yuhsinnet/rfid-mobile/RFID-mobileV_1_0/todo.txt

1.ST-LINK 腳位與LoRa 通信腳位過近，不方便使用。
2.RFID 通信腳位使用錯誤(TX RX 交換)。
3.電源3.3V 應由電池端供電，不能由5V 供電。
