yuhsinnet/rfid-mobile/BMW 50010_Case-PCB_dege.dxf

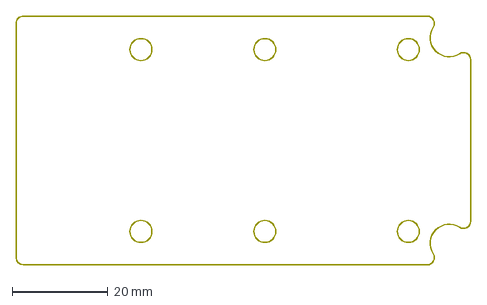
[picture p1: CAD file, 2022-05-01]
BMW 50010_Case-PCB_dege.dxf
95.0 x 52.0 mm
