yuhsinnet/rfid-mobile/BMW 50010_Case.dxf

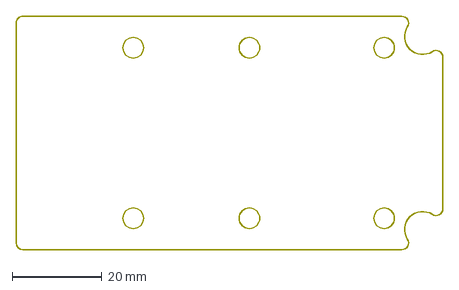
[picture p2: CAD file, 2022-05-01]
BMW 50010_Case.dxf
95.0 x 52.0 mm
