yuhsinnet/rfid-mobile/BMC 70020-Case-PCB_Edge.dxf

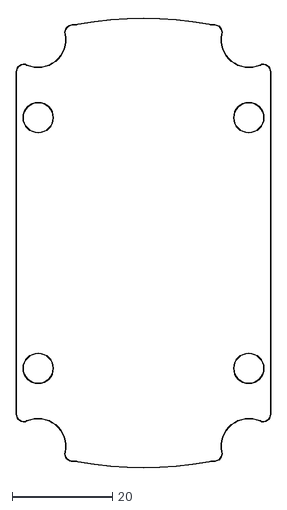
[picture p3: CAD file, 2022-04-29]
BMC 70020-Case-PCB_Edge.dxf
50.7 x 90.3
