yuhsinnet/rfid-mobile/CaseCAD.dxf

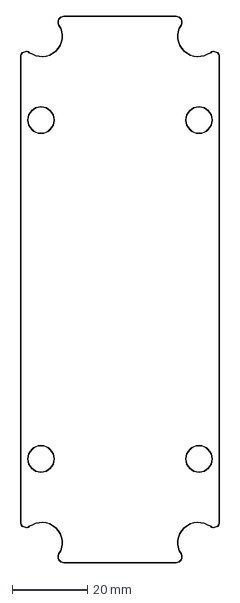
[picture p4: CAD file, 2022-04-24]
CaseCAD.dxf
52.9 x 145.1 mm
