yuhsinnet/rfid-mobile/(list of files, cad)

Other CAD files:
BMC 70020-Case-PCB_Edge_V2.dwg
BMC 70020-Case-raw.dwg
BMC 70022-PDF-CAD.dwg
BMC 70020-Case-PCB_Edge.dwg
BMW 50010_Case-PCB_dege.dwg
CaseCAD.dwg
