yuhsinnet/rfid-mobile/RFID-mobileV_1_0/RFID-mobileV_1_0.kicad_pcb

## KiCad design RFID-mobileV_1_0/RFID-mobileV_1_0.kicad_pcb (2022-06-02)

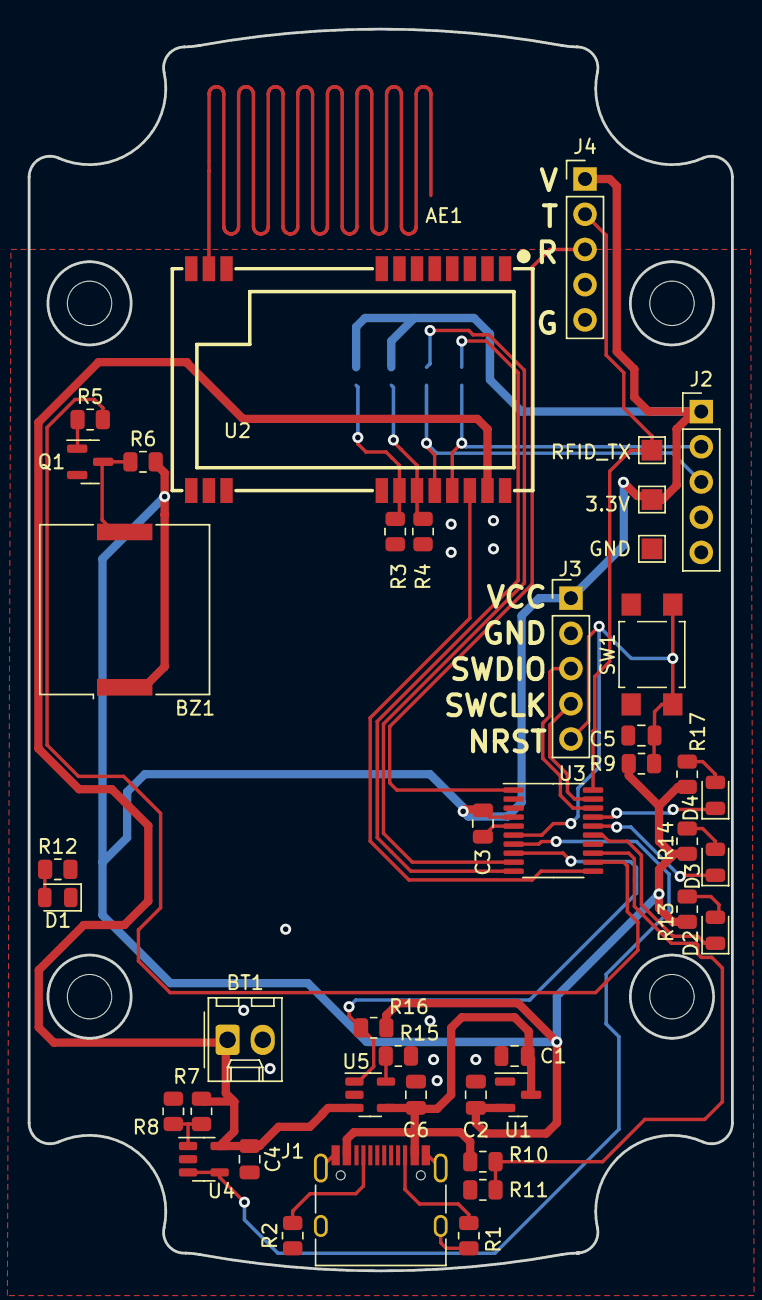
[picture p5: board RFID-mobileV_1_0.kicad_pcb from above]

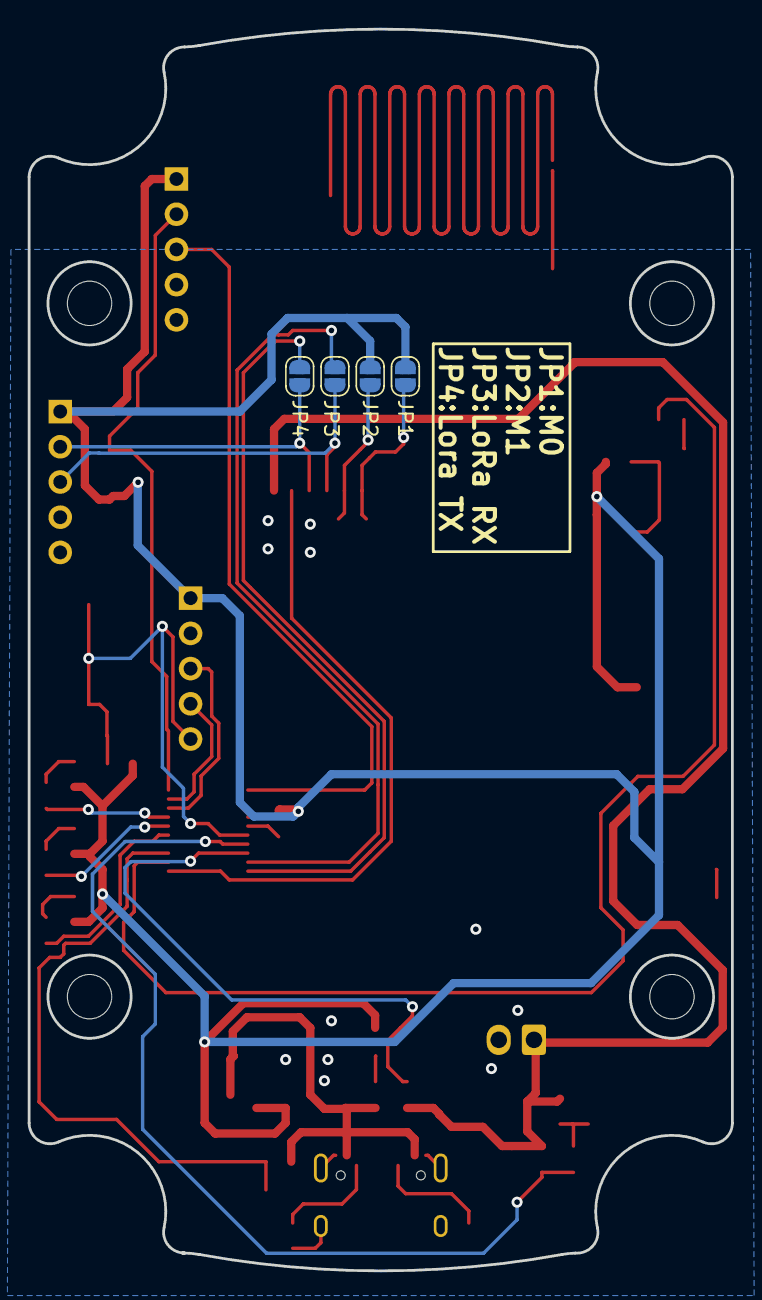
[picture p6: board RFID-mobileV_1_0.kicad_pcb from below]

Board: 2 copper layers, 50.7 x 89.5 mm, 52 parts (4 on the bottom side), 34 nets.

Parts:
AE1: Antenna; 433MHz_V
BT1: Battery; Molex_KK-254_AE-6410-02A_1x02_P2.54mm_Vertical
BZ1: Buzzer; Buzzer_Murata_PKLCS1212E
C1, C2, C3, C4, C5, C6: 0.1uF; C_0805_2012Metric
D1: PWR; LED_0805_2012Metric
D2, D3, D4: LED; LED_0805_2012Metric
H1, H2, H3, H4: MountingHole; MountingHole_3.2mm_M3
J1: USB_C_Receptacle_USB2.0; USB_C_Receptacle_HRO_TYPE-C-31-M-12
J2, J4: Conn_01x05_Male; PinHeader_1x05_P2.54mm_Vertical
J3: Conn_01x05_Female; PinHeader_1x05_P2.54mm_Vertical
JP1, JP2, JP3, JP4: SolderJumper_2_Open; SolderJumper-2_P1.3mm_Open_RoundedPad1.0x1.5mm
Q1: MMBT3904; SOT-23
R1, R2: 5K1; R_0805_2012Metric
R3, R4, R6, R13, R14, R17: 1k; R_0805_2012Metric
R5: 22k; R_0805_2012Metric
R7, R8: 2M; R_0805_2012Metric
R9, R16: 10k; R_0805_2012Metric
R10: 47k; R_0805_2012Metric
R11: 91k; R_0805_2012Metric
R12: 330; R_0805_2012Metric
R15: 1.65K; R_0805_2012Metric
SW1: SW_Push; SW_SPST_TL3305A
TP1: RFID_TX; TestPoint_Pad_1.5x1.5mm
TP2: 3.3V; TestPoint_Pad_1.5x1.5mm
TP3: GND; TestPoint_Pad_1.5x1.5mm
U1: XC6206P332MR; SOT-23
U2: E22-400T22S; E220-400TxxS
U3: STM32G030FxP; TSSOP-20_4.4x6.5mm_P0.65mm
U4: LM321; SOT-23-5
U5: TP4054; TSOT-23-5

Connections:
+3V3: BZ1.1 (-), C2.1, C3.1, J2.1, J3.1, J4.1, JP1.2 (B), JP2.2 (B), R6.2, R9.1, R12.2, R13.2, R14.2, R16.1, R17.2, TP2.1, U1.2 (VO), U3.4 (VDD/VDDA)
+5V: C1.1, C6.1, J1.A4 (VBUS), J1.A9 (VBUS), J1.B4 (VBUS), J1.B9 (VBUS), R10.1, U1.3 (VI), U5.4 (VCC)
+BATT: BT1.1 (+), C4.1, R7.1, U2.25 (VCC), U4.5 (V+), U5.3 (BAT)
/ANT: AE1.1 (A), U2.12 (ANT)
/BATT_moint: U3.7 (PA0), U4.3 (-), U4.4
/CC1: J1.A5 (CC1), R2.2
/CC2: J1.B5 (CC2), R1.2
/CHAR_STAT: R16.2, U3.8 (PA1), U5.1 (~CHRG)
/LoRa_AUX: U2.24 (AUX), U3.11 (PA4)
/LoRa_RXD: JP3.2 (B), U3.9 (PA2)
/LoRa_RXD_: J2.3, JP3.1 (A), U2.22 (RXD)
/LoRa_TXD: JP4.2 (B), U3.10 (PA3)
/LoRa_TXD_: J2.2, JP4.1 (A), U2.23 (TXD)
/M0: JP1.1 (A), R3.2, U2.20 (M0)
/M1: JP2.1 (A), R4.2, U2.21 (M1)
/NRST: C5.1, J3.5, R9.2, SW1.2, U3.6 (NRST)
/PA8: D2.1 (K), U3.15 (PB0/PB1/PB2/PA8)
/PA9: D3.1 (K), U3.16 (PA11[PA9])
/PA10: D4.1 (K), U3.17 (PA12[PA10])
/RFID_RXD_: J4.3, U3.1 (PB7/PB8)
/RFID_TXD_: J4.2, TP1.1, U3.20 (PB3/PB4/PB5/PB6)
/SWCLK: J3.4, U3.19 (PA15/PA14-BOOT0)
/SWDIO: J3.3, U3.18 (PA13)
/VBUS_sing: R10.2, R11.1, U3.13 (PA6)
/buz: R5.2, U3.12 (PA5)
GND: BT1.2 (-), C1.2, C2.2, C3.2, C4.2, C5.2, C6.2, D1.1 (K), J1.A1 (GND), J1.A12 (GND), J1.B1 (GND), J1.B12 (GND), J1.S1 (SHIELD), J2.5, J3.2, J4.5, Q1.2 (E), R1.1, R2.1, R3.1, R4.1, R8.2, R11.2, R15.2, SW1.1, TP3.1, U1.1 (GND), U2.2 (GND), U2.8 (GND), U2.11 (GND), U2.13 (GND), U2.14 (GND), U2.15 (GND), U2.16 (GND), U2.19 (GND), U2.26 (GND), U3.5 (VSS/VSSA), U4.2 (V-), U5.2 (GND)
unnamed: BZ1.2 (+), Q1.3 (C), R6.1
unnamed: D1.2 (A), R12.1
unnamed: D2.2 (A), R13.1
unnamed: D3.2 (A), R14.1
unnamed: D4.2 (A), R17.1
unnamed: Q1.1 (B), R5.1
unnamed: R7.2, R8.1, U4.1 (+)
unnamed: R15.1, U5.5 (PROG)
