yuhsinnet/rfid-mobile/RFID-siteV_1_0/RFID-siteV_1_0.kicad_pcb

## KiCad design RFID-siteV_1_0/RFID-siteV_1_0.kicad_pcb (2022-06-02)

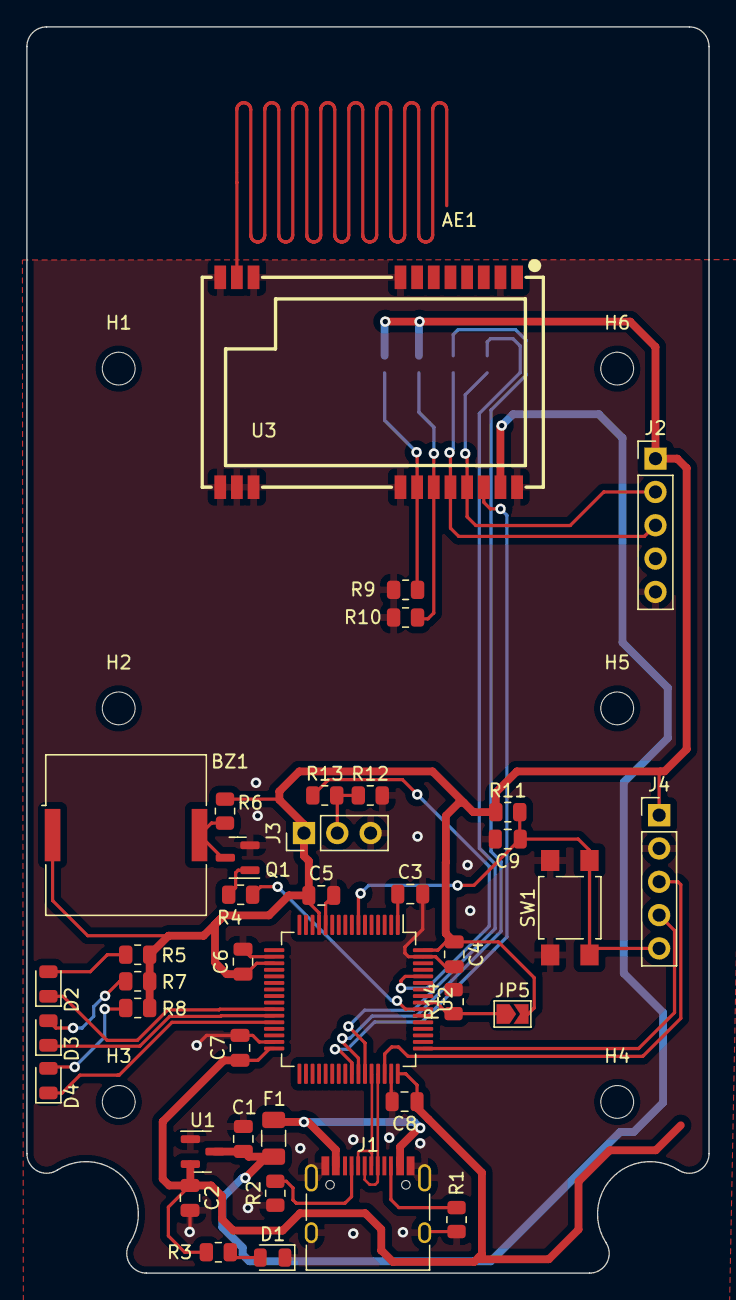
[picture p7: board RFID-siteV_1_0.kicad_pcb from above]

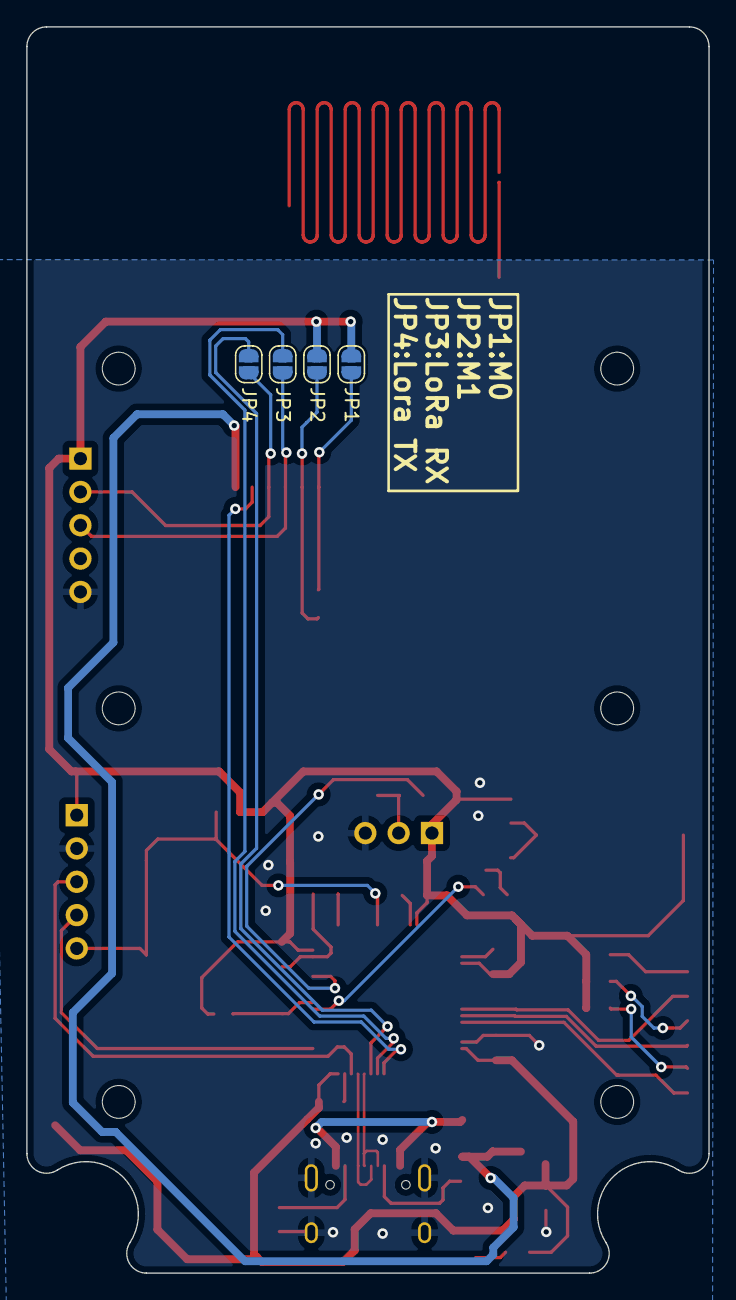
[picture p8: board RFID-siteV_1_0.kicad_pcb from below]

Board: 2 copper layers, 52.0 x 95.0 mm, 50 parts (4 on the bottom side), 33 nets.

Parts:
AE1: Antenna; 433MHz_V
BZ1: Buzzer; Buzzer_Murata_PKLCS1212E
C1, C2, C3, C4, C5, C6, C7, C8, C9: 0.1uF; C_0805_2012Metric
D1: PWR; LED_0805_2012Metric
D2, D3, D4: LED; LED_0805_2012Metric
F1: Fuse 200mA; Fuse_1206_3216Metric
H1, H2, H3, H4, H5, H6: MountingHole; MountingHole_2.5mm
J1: USB_C_Receptacle_USB2.0; USB_C_Receptacle_HRO_TYPE-C-31-M-12
J2: Conn_01x05_Male; PinHeader_1x05_P2.54mm_Vertical
J3: Conn_01x03_Male; PinHeader_1x03_P2.54mm_Vertical
J4: Conn_01x05_Female; PinHeader_1x05_P2.54mm_Vertical
JP1, JP2, JP3, JP4: SolderJumper_2_Open; SolderJumper-2_P1.3mm_Open_RoundedPad1.0x1.5mm
JP5: SolderJumper_2_Open; SolderJumper-2_P1.3mm_Open_TrianglePad1.0x1.5mm
Q1: MMBT3904; SOT-23
R1, R2: 5K1; R_0805_2012Metric
R3: 330; R_0805_2012Metric
R4: 22k; R_0805_2012Metric
R5, R6, R7, R8, R9, R10, R13, R14: 1k; R_0805_2012Metric
R11: 10k; R_0805_2012Metric
R12: 0R; R_0805_2012Metric
SW1: SW_Push; SW_SPST_TL3305A
U1: XC6206P332MR; SOT-23
U2: STM32L053R8Tx; LQFP-64_10x10mm_P0.5mm
U3: E22-400T22S; E220-400TxxS

Connections:
+3V3: BZ1.1 (-), C2.1, C4.1, C5.1, C6.1, C7.1, C8.1, J2.1, J3.1, J4.1, JP1.2 (B), JP2.2 (B), JP5.2 (B), R3.2, R5.2, R6.2, R7.2, R8.2, R11.1, U1.2 (VO), U2.13 (VDDA), U2.19 (VDD), U2.32 (VDD), U2.48 (VDD_USB), U2.64 (VDD)
+5V: C1.1, F1.1, U1.3 (VI), U3.25 (VCC)
/ANT: AE1.1 (A), U3.12 (ANT)
/BOOT0: R13.1, U2.60 (BOOT0)
/CC1: J1.A5 (CC1), R2.2
/CC2: J1.B5 (CC2), R1.2
/L53R8_UART1_RX: JP4.2 (B), U2.43 (PA10)
/L53R8_UART1_TX: JP3.2 (B), U2.42 (PA9)
/LoRa_AUX: U2.41 (PA8), U3.24 (AUX)
/LoRa_RXD_: J2.3, JP3.1 (A), U3.22 (RXD)
/LoRa_TXD_: J2.2, JP4.1 (A), U3.23 (TXD)
/M0: JP1.1 (A), R9.2, U3.20 (M0)
/M1: JP2.1 (A), R10.2, U3.21 (M1)
/NRST: C9.1, J4.5, R11.2, SW1.2, U2.7 (NRST)
/PB0: D2.1 (K), U2.26 (PB0)
/PB1: D3.1 (K), U2.27 (PB1)
/PB2: D4.1 (K), U2.28 (PB2)
/SWCLK: J4.4, U2.49 (PA14)
/SWDIO: J4.3, U2.46 (PA13)
/USB_D+: J1.A6 (D+), J1.B6 (D+), U2.45 (PA12)
/USB_D-: J1.A7 (D-), J1.B7 (D-), U2.44 (PA11)
/buz: R4.2, U2.55 (PB3)
/mod_sel: JP5.1 (A), R14.1, U2.56 (PB4)
GND: C1.2, C2.2, C3.2, C4.2, C5.2, C6.2, C7.2, C8.2, C9.2, D1.1 (K), J1.A1 (GND), J1.A12 (GND), J1.B1 (GND), J1.B12 (GND), J1.S1 (SHIELD), J2.5, J3.3, J4.2, Q1.2 (E), R1.1, R2.1, R9.1, R10.1, R12.2, R14.2, SW1.1, U1.1 (GND), U2.12 (VSSA), U2.18 (VSS), U2.31 (VSS), U2.47 (VSS), U2.63 (VSS), U3.2 (GND), U3.8 (GND), U3.11 (GND), U3.13 (GND), U3.14 (GND), U3.15 (GND), U3.16 (GND), U3.19 (GND), U3.26 (GND)
unnamed: BZ1.2 (+), Q1.3 (C), R6.1
unnamed: C3.1, U2.1 (VLCD)
unnamed: D1.2 (A), R3.1
unnamed: D2.2 (A), R5.1
unnamed: D3.2 (A), R7.1
unnamed: D4.2 (A), R8.1
unnamed: F1.2, J1.A4 (VBUS), J1.A9 (VBUS), J1.B4 (VBUS), J1.B9 (VBUS)
unnamed: J3.2, R12.1, R13.2
unnamed: Q1.1 (B), R4.1
