yuhsinnet/rfid-mobile/RFID-siteV_1_0/todo.txt

1.ST-LINK 腳位上下顛倒，接腳不便使用。
2.缺少模式(加符號&不加符號)選擇接點。
