yuhsinnet/rfid-mobile/(commit log)

2022-04-20 add type-c
    [RFID-mobileV_1_0.kicad_pcb, RFID-mobileV_1_0.kicad_sch]
2022-04-21 增加電池管理IC
    [RFID-mobileV_1_0.kicad_sch]
2022-04-21 update sch
    [RFID-mobileV_1_0.kicad_sch]
2022-04-23 add ign update sch
    [RFID-mobileV_1_0.kicad_sch]
2022-04-23 Update RFID-mobileV_1_0.kicad_sch
    AUX pin
    [RFID-mobileV_1_0.kicad_sch]
2022-04-24 add board edge
    [BMC 70022-PDF-CAD.dwg, CaseCAD.dwg, CaseCAD.dxf, RFID-mobileV_1_0.kicad_pcb, RFID-mobileV_1_0.kicad_sch]
2022-04-28 Update RFID-mobileV_1_0.kicad_pcb
    remove Case box
    [RFID-mobileV_1_0.kicad_pcb]
2022-04-29 add
    PCB Broad edge
    place Device
    [BMC 70020-Case-PCB_Edge.dwg, BMC 70020-Case-PCB_Edge.dxf, BMC 70020-Case-raw.dwg, RFID-mobileV_1_0.kicad_pcb, RFID-mobileV_1_0.kicad_sch]
2022-04-29 pcb update
    [RFID-mobileV_1_0.kicad_pcb]
2022-04-29 update
    remote DW02
    [RFID-mobileV_1_0.kicad_pcb, RFID-mobileV_1_0.kicad_sch]
2022-04-29 add jlcpcb
    [BOM-RFID-mobileV_1_0.csv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]
2022-04-30 create site
    [RFID-siteV_1_0.kicad_pcb, RFID-siteV_1_0.kicad_sch]
2022-05-01 Update RFID-siteV_1_0.kicad_sch
    add boot 0 select pin
    [RFID-siteV_1_0.kicad_sch]
2022-05-01 add PCB
    [RFID-siteV_1_0.kicad_pcb]
2022-05-01 Update RFID-siteV_1_0.kicad_sch
    SWD
    [RFID-siteV_1_0.kicad_sch]
2022-05-02 fix BT1
    [RFID-mobileV_1_0.kicad_pcb, RFID-mobileV_1_0.kicad_sch]
2022-06-02 Update RFID-siteV_1_0.kicad_pcb
    V1.ST-LINK 腳位上下顛倒，接腳不便使用。
    V2.缺少模式(加符號&不加符號)選擇接點。
    [RFID-siteV_1_0.kicad_pcb]
2022-06-02 Update RFID-siteV_1_0.kicad_sch
    add 模式選擇點(jump)
    [RFID-siteV_1_0.kicad_sch]
2022-06-02 Update RFID-mobileV_1_0.kicad_sch
    V2.RFID 通信腳位使用錯誤(TX RX 交換)。
    V3.電源3.3V 應由電池端供電，不能由5V 供電。
    [RFID-mobileV_1_0.kicad_sch]
2022-06-02 Create BMC 70020-Case-PCB_Edge_V2.bak
